ojousima/poppimASiina/hardware/LTSpice/differential2single.asc

C2: cap; 470µ
C3: cap; 470µ
C5: cap; 47p
C6: cap; 47p
C8: cap; 150µ
C9: cap; 150µ
R1: res; 10k
R2: res; 10k
R3: res; 10k
R4: res; 10k
R5: res; 16
R8: res; 10k
R9: res; 10k
R10: res; 10k
R11: res; 10k
R12: res; 16
R19: res; 16
R20: res; 16
U2: LT6221
U4: LT6221
U5: LTC660
V1: voltage; 4.2
V2: voltage; SINE(0 0.25 1k 0 0 0 1k); AC 0.5
V3: voltage; SINE(0 0.25 1k 0 0 0 1k); AC 0.5
V4: voltage; 1.5
V5: voltage; SINE(0 0.25 1k 0 0 0 1k); AC 0.5
V6: voltage; SINE(0 0.25 1k 0 0 0 1k); AC 0.5
V7: voltage; 1.5
V8: voltage; 1.5
V9: voltage; 1.5
Named nets: 0, VAA, LEFT_OUT, LEFT_IN-, LEFT_IN+, VCOM, RIGHT_OUT, RIGHT_IN-, RIGHT_IN+, RIGHT_SE, LEFT_SE, VEE
.OPTIONS plotwinsize=0
.OPTIONS numdgt=7
.tran 0 150m 100m 1u startup
;ac oct 1k 1m 100meg
.FOUR 1k 10 V(RIGHT_OUT)
