ojousima/poppimASiina/hardware/LTSpice/analog.asc

C1: cap; 2µ2
C2: cap; 470µ
C3: cap; 470µ
C4: cap; 470µ
C5: cap; 47p
C6: cap; 47p
C7: cap; 47p
R1: res; 10k
R2: res; 10k
R3: res; 10k
R4: res; 10k
R5: res; 5k
R6: res; 1meg
R7: res; 1meg
R8: res; 10k
R9: res; 10k
R10: res; 10k
R11: res; 10k
R12: res; 5k
R13: res; 10k
R14: res; 10k
R15: res; 10k
R16: res; 10k
R17: res; 5k
R18: res; 5k
R19: res; 5k
R20: res; 5k
U1: LTC6255
U2: LTC6255
U3: LTC6255
U4: LTC6255
V1: voltage; 4.2
V2: voltage; wavefile=leftch_in.wav
V3: voltage; wavefile=leftch_in.wav
V4: voltage; 1.5
V5: voltage; wavefile=rightch_in.wav
V6: voltage; wavefile=rightch_in.wav
V7: voltage; 1.5
V8: voltage; 1.5
V9: voltage; 1.5
Named nets: 0, VAA, LEFT_OUT, LEFT_IN-, LEFT_IN+, VCOM, RIGHT_OUT, RIGHT_IN-, RIGHT_IN+, MONO_OUT, LEFT_SE, RIGHT_SE
.OPTIONS plotwinsize=0
.OPTIONS numdgt=7
.tran 0 35 0 1u startup
.wave "rightch_out.wav"  16 44k1 V(RIGHT_OUT)
.wave "leftch_out.wav"  16 44k1 V(MONO_OUT)
.wave "mono_out.wav" 16 44k1 V(MONO_OUT)
.wave "left_monitor.wav" 16 44k1 V(LEFT_IN+)
.wave "right_monitor.wav" 16 44k1 V(RIGHT_IN+)
