ojousima/poppimASiina/hardware/musamasiina.kicad_pcb

## KiCad design hardware/musamasiina.kicad_pcb (2016-06-10)

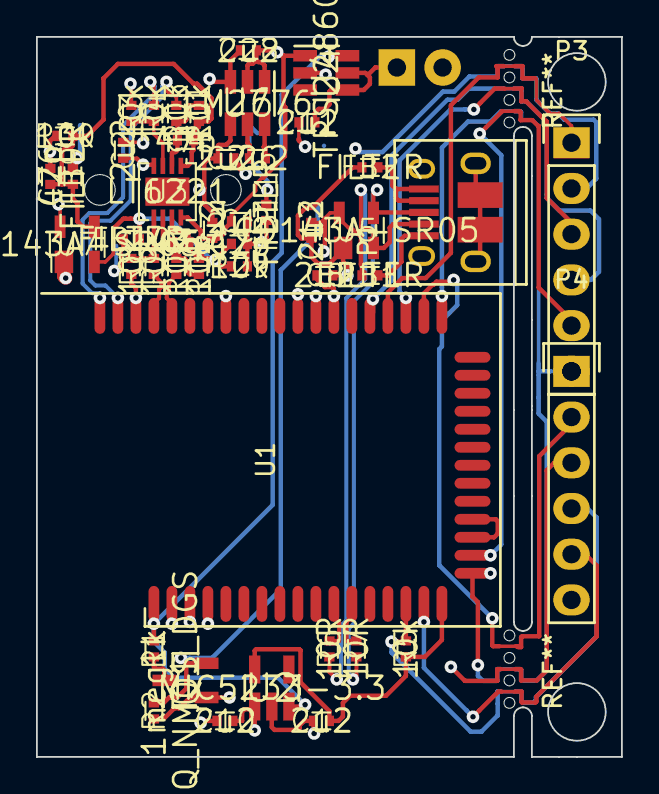
[picture p1: board musamasiina.kicad_pcb from above]

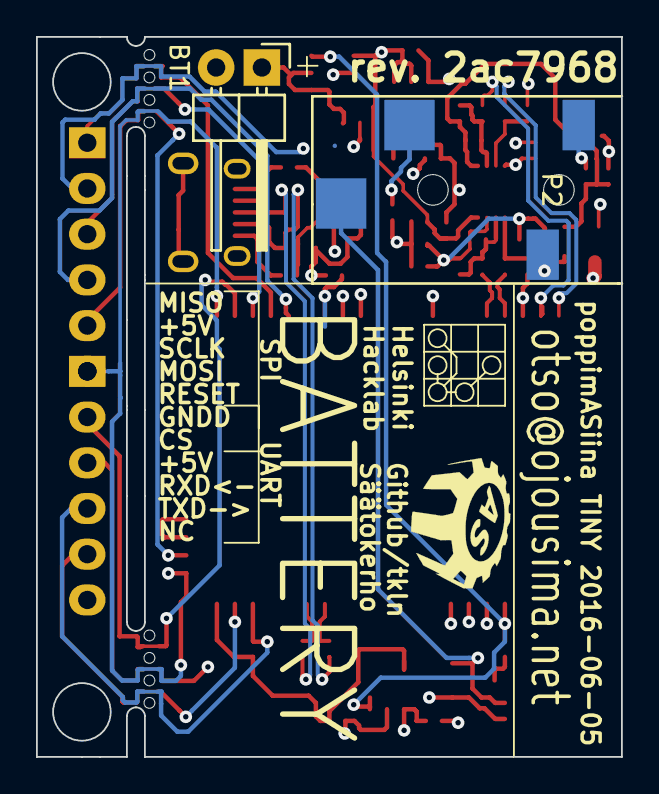
[picture p2: board musamasiina.kicad_pcb from below]

Board: 4 copper layers, 32.5 x 40.0 mm, 48 parts (2 on the bottom side), 39 nets.

Parts:
BT1: Battery; Pin_Header_Angled_1x02
C1, C2, C3, C6, C7, C8, C10, C11, C12, C13, C28: 2u2; SMD0402-CAP-N
C4, C5, C26, C27: 47p; SMD0402-CAP-N
FB1, FB2, FB9, FB10, FB11: FILTER; SMD0402-FERRITE-N
P1: USB_OTG; USB_Micro-B_10103594-0001LF
P2: CONN_01X04; SMD_3-5mm_jack_CUI-SJ-352X-SMT
P3: CONN_02X03; Pin_Header_Straight_1x06
P4: CONN_01X06; Pin_Header_Straight_1x06
Q1: Q_NMOS_DGS; SOT23-M
R1: 1k; SMD0402-RES-N
R2: 1meg; SMD0402-RES-N
R3, R4, R5, R8, R9, R10, R11, R12, R13, R29, R30: 10k; SMD0402-RES-N
R6, R7: 10R; SMD0402-RES-N
U1: WT32
U2: MIC5233-3.3; SOT23-5-M
U3: LT6221; DFN-8-EP-0_5mm_3x3mm-N
U4: TPS22860; SOT23-6-M
U5, U7: CD143A-SR05; SOT143-N
U6: LM2776; SOT23-6-M

Connections:
+5V: C13.1, FB1.2, P3.2, P4.3, U1.38, U5.4
+BATT: BT1.1, C8.1, C10.1, C11.1, Q1.1, R2.1, U1.37, U2.1, U4.4, U4.5
/AUDIO_SWITCH: P2.4, Q1.2, R2.2
/CD+: R7.1, U1.12
/CD-: R6.1, U1.11
/CS: P4.2, U1.32
/LO_N: R13.2, U1.49
/LO_P: R4.2, U1.50
/MISO: P3.1, U1.34
/MOSI: P3.4, U1.35
/Power Supply/ENABLE: R1.1, U1.1, U2.3, U4.6
/Power Supply/GNDBUS: FB2.1, P1.4, P1.5
/Power Supply/VBUS: FB1.1, P1.1
/RESET: P3.5, U1.19
/RO_N: R10.2, U1.46
/RO_P: R9.2, U1.47
/RXD: P4.4, R5.1, U1.15
/SCLK: P3.3, U1.33
/Stereo out/GROUND_CABLE: FB11.2, P2.2
/Stereo out/LEFT_CABLE: FB9.2, P2.1
/Stereo out/LEFT_DEVICE: C4.1, C26.1, FB9.1, R11.1, R30.1, U3.1, U7.3
/Stereo out/RIGHT_CABLE: FB10.2, P2.3
/Stereo out/RIGHT_DEVICE: C5.1, C27.1, FB10.1, R12.1, R29.1, U3.7, U7.2
/TXD: P4.5, U1.16
/USB_D+: P1.3, R7.2, U5.3
/USB_D-: P1.2, R6.2, U5.2
GNDA: C1.2, C2.2, C7.2, C26.2, C27.2, C28.2, FB11.1, R3.2, R8.2, R29.2, R30.2, U1.39, U1.43, U1.48, U4.2, U6.3
GNDD: BT1.2, C8.2, C10.2, C11.2, C12.2, C13.2, FB2.2, P3.6, P4.1, U1.2, U1.3, U1.4, U1.18, U1.31, U2.2, U5.1
unnamed: C4.2, R11.2, R13.1, U3.2
unnamed: C5.2, R10.1, R12.2, U3.6
unnamed: C6.1, U6.5
unnamed: C6.2, U6.6
unnamed: Q1.3, R1.2
unnamed: R3.1, R4.1, U3.3
unnamed: R8.1, R9.1, U3.5
unnamed: U1.20, U1.21
VAA: C1.1, C3.1, C28.1, U3.8, U4.1, U6.1, U6.2, U7.4
VDD: C12.1, R5.2, U1.17, U2.5
VEE: C2.1, C3.2, C7.1, U3.4, U6.4, U7.1
