ojousima/poppimASiina/hardware/printout/simulation/differential2single-bode.png

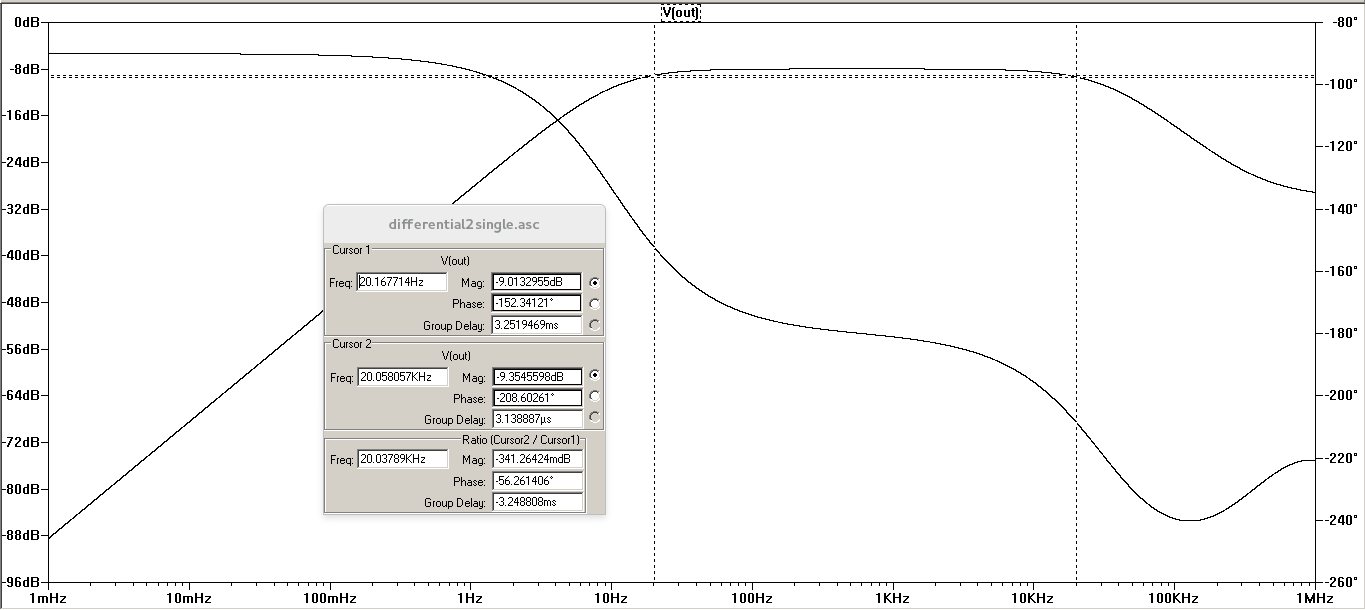
hardware/printout/simulation/differential2single-bode.png
