ojousima/poppimASiina/hardware/printout/simulation/differential2single-DC-32load-2v7supply.png

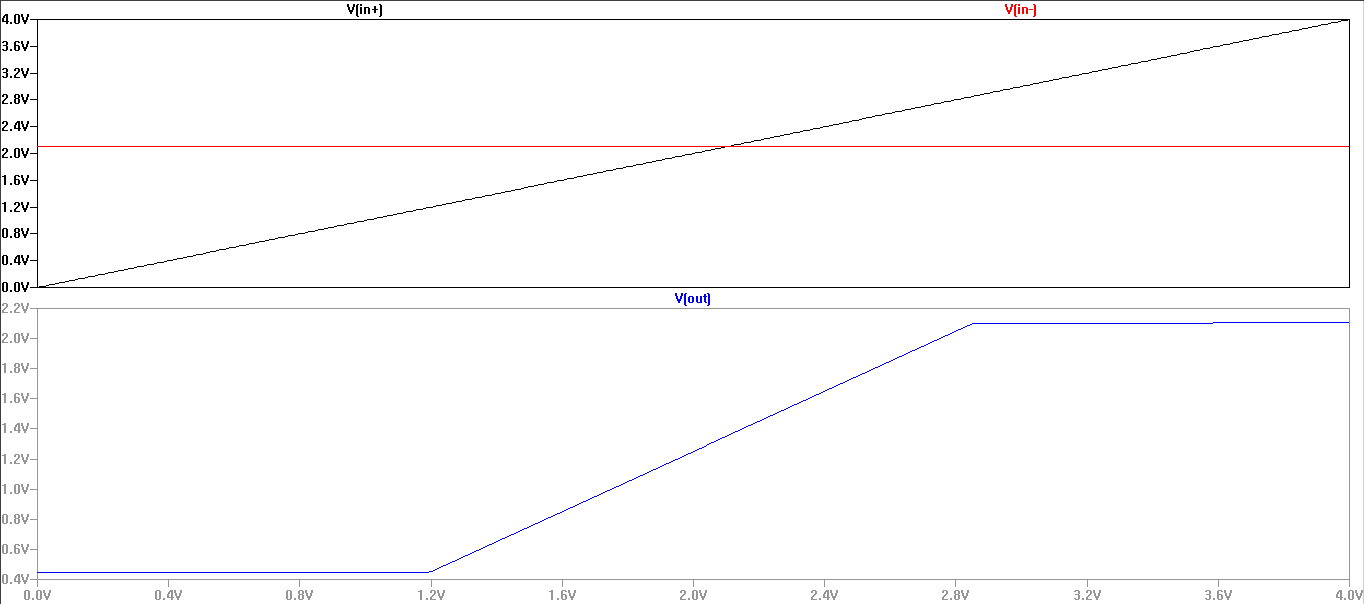
hardware/printout/simulation/differential2single-DC-32load-2v7supply.png
