ojousima/poppimASiina/hardware/printout/simulation/differential2single-DC-32load-4v2supply.png

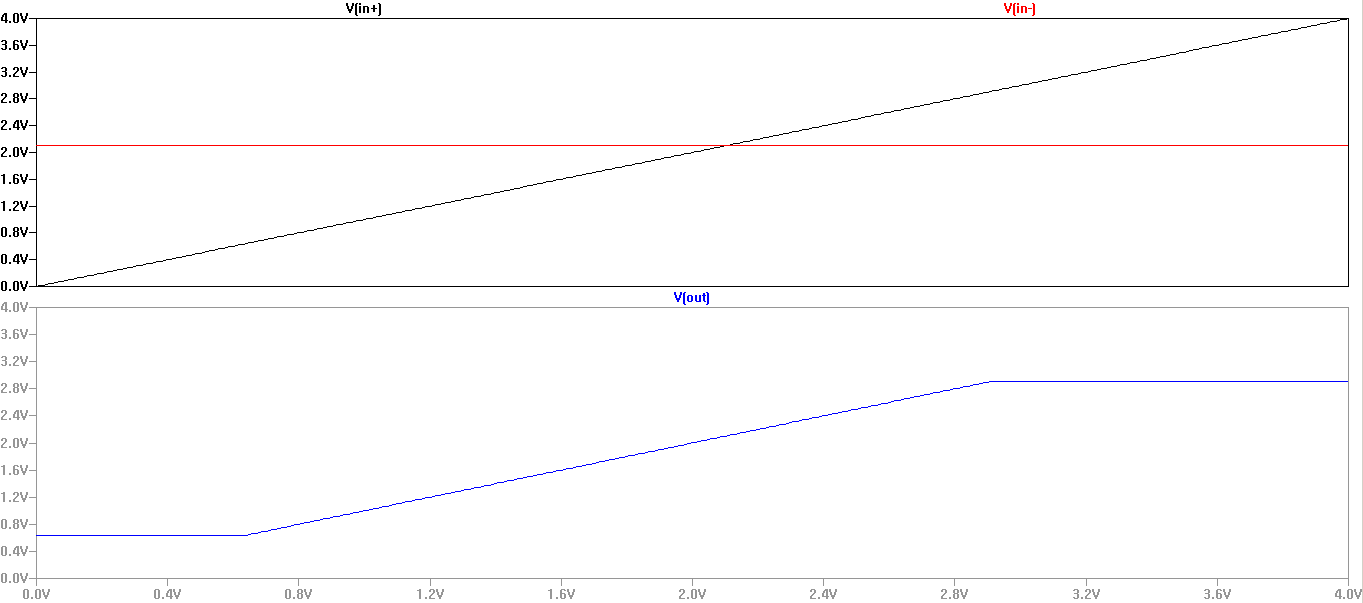
hardware/printout/simulation/differential2single-DC-32load-4v2supply.png
