ojousima/poppimASiina/hardware/printout/simulation/differential2single-FFT.png

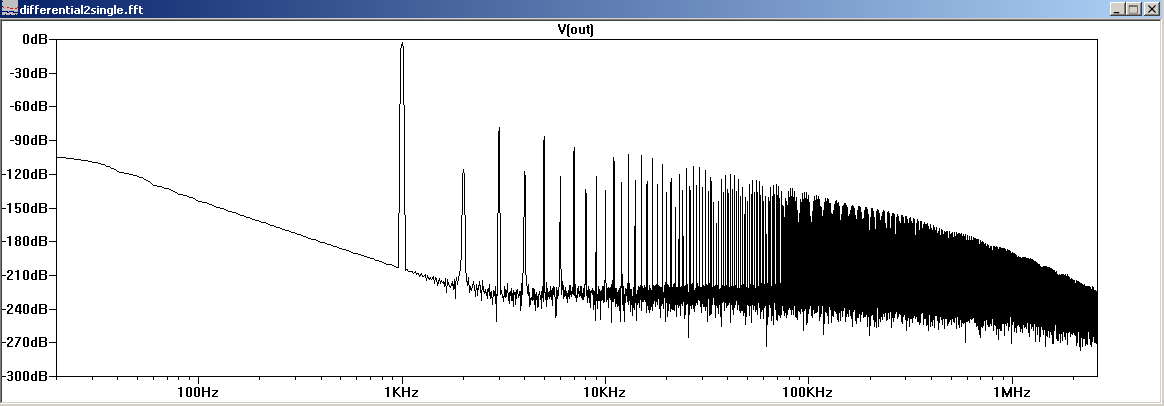
hardware/printout/simulation/differential2single-FFT.png
