ojousima/poppimASiina/hardware/printout/simulation/differential2single-noise.png

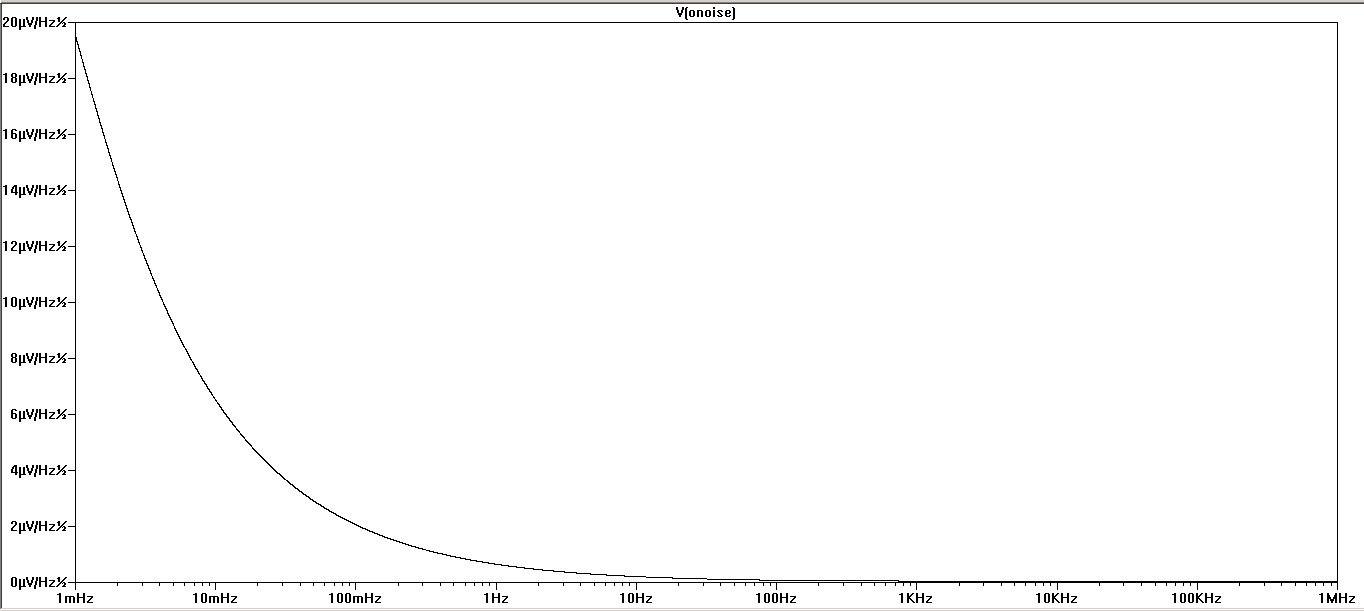
hardware/printout/simulation/differential2single-noise.png
