ojousima/poppimASiina/hardware/printout/simulation/differential2single.png

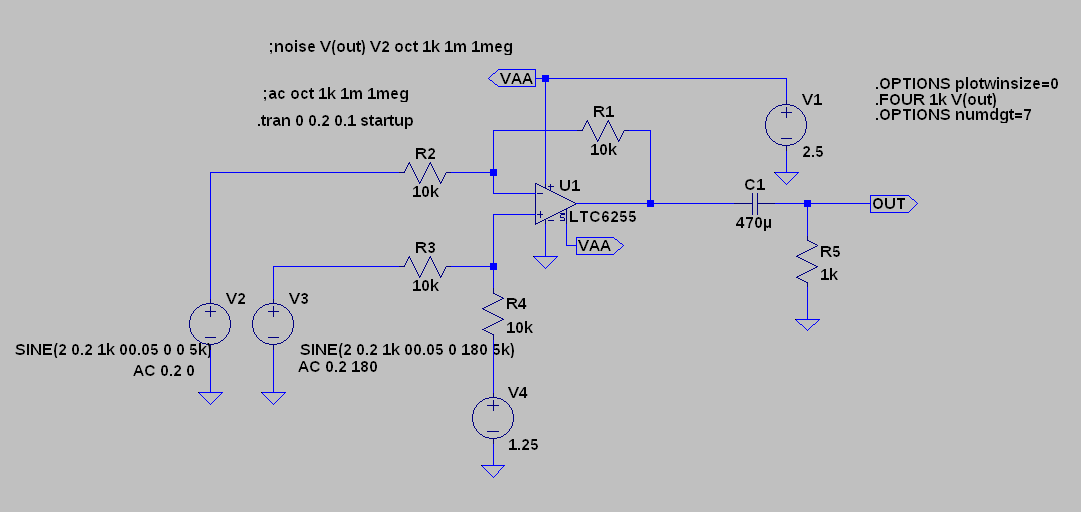
hardware/printout/simulation/differential2single.png
