ojousima/poppimASiina/hardware/printout/simulation/differential2single_TD.png

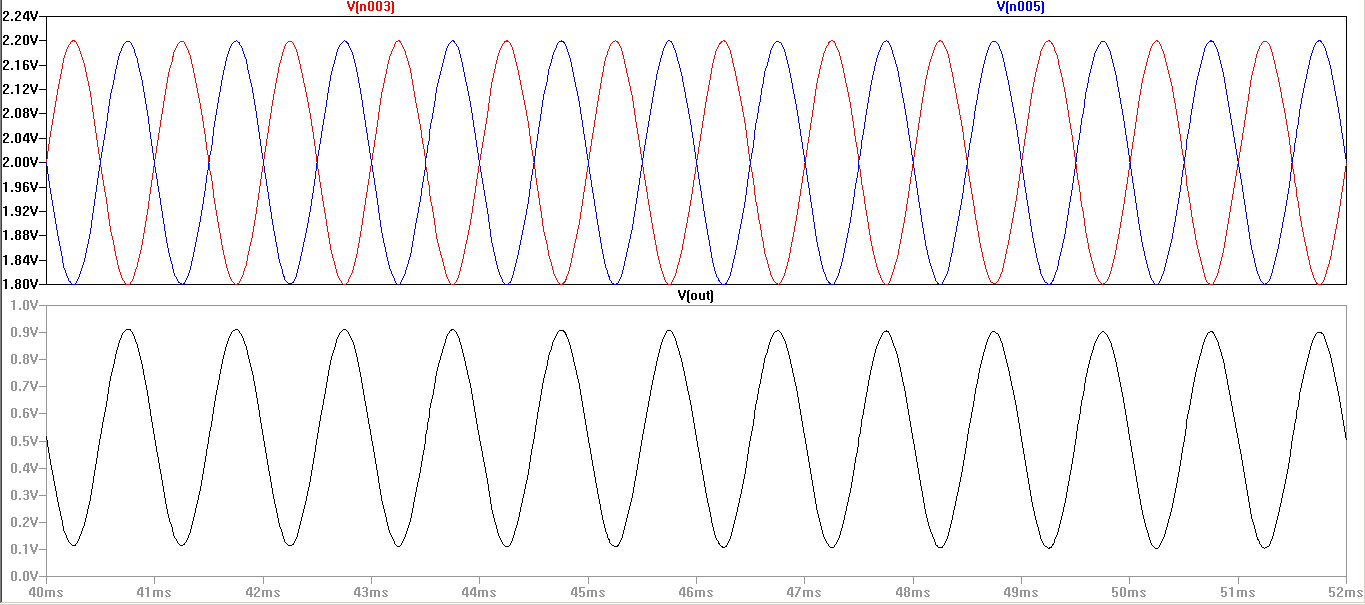
hardware/printout/simulation/differential2single_TD.png
