ojousima/poppimASiina/(threads)

Thread 1 (2016-05-19):

ID pin connection?

ojousima, 2016-05-19:
ID pin on USB connector should be connected to a defined level. A quick search on internet suggests ground ID pin would signal OTG devices to act as a master, so maybe ID pin should be grounded?

Thread 3 (2016-05-19):

TPS22860 grounding?

ojousima, 2016-05-19:
The load switch TPS22860 has only one ground pin. Should it be connected on load side GNDA or source side GNDD?

ojousima, 2016-05-20:
Datasheet has ground (and bypass cap) next to VOUT, so maybe GNDA?

Thread 5 (2016-05-19):

UART pins are not brought out

ojousima, 2016-05-19:
FTDI-cable compatible programming header would be nice.

ojousima, 2016-05-21:
Fixed in 85a3737

Closed 2016-05-21.

Thread 7 (2016-05-21):

PCB footprints

ojousima, 2016-05-21:
SOT23-5 and SOT23-6 should have their 3D axis rotated around Z-axis by 270 deg.
SOT23-6 needs pin 1 indicator.
SOT23-3 has misplaced pads.

Thread 10 (2016-05-28):

DC-level setting resistors after DC-decoupling of audio IO

ojousima, 2016-05-28:
As there is no resistive path to ground after DC-decoupling of audio stages, there is going to be click & pop when cable is connected. This could be reduced by adding a high value resistor on the signal lines, maybe 1 meg or so.

Closed 2016-05-31.

Thread 12 (2016-05-31):

USB footprint

ojousima, 2016-05-31:
A completely SMD-version of USB connector would allow a button on the other side of the board. On the other hand, full SMD-footprint might be less robust. Should it be changed?

Thread 13 (2016-05-31):

Battery reverse protection, connector.

ojousima, 2016-05-31:
Add reverse protection (NMOS on ground?) and decide on battery connector footprint.

Thread 14 (2016-05-31):

On/Off button selection

ojousima, 2016-05-31:
Panel mount buttons tend to be large (adds to height of device), suitable SMD buttons are expensive (4-5 USD) or would need additional mechanics.

A button type needs to be selected.
