ojousima/poppimASiina/(commit log)

2016-05-15 Ignore kicad backup, autogenerated files
2016-05-15 Add header, printout
    [musamasiina.sch]
2016-05-15 Add printouts of simulation results
2016-05-15 Add analog sections to schematic
    [musamasiina.sch]
2016-05-15 Update schematic printout
2016-05-15 Fix ESD-protection diodes
    [musamasiina.sch]
2016-05-15 Update printouts
    [musamasiina.sch]
2016-05-15 Start vorking on PSU
    [musamasiina.sch]
2016-05-15 Update printout
2016-05-19 Schematic ready for review
    [musamasiina.sch]
2016-05-19 Update header, printout
    [musamasiina.sch]
2016-05-20 Fix #2
    Corrected BAT54S pin order, updated schematic
    [musamasiina.sch]
2016-05-20 Add AC-coupling caps to mic input. Fixes #4
    [musamasiina.sch]
2016-05-21 divide schematic into subscheets
    [analog.sch, musamasiina.sch, psu.sch]
2016-05-21 Add user IO, programming headers
    [analog.sch, audioio.sch, musamasiina.sch, psu.sch]
2016-05-21 update schematic headers, printouts
    [analog.sch, audioio.sch, musamasiina.sch, psu.sch]
2016-05-21 Add standard footprints
2016-05-31 Fix annotation of VESD resistors
    Fix annotation of VESD resistors
    [analog.sch, audioio.sch, musamasiina.sch, psu.sch]
2016-05-31 draft PCB outline, import standard components
    [musamasiina.kicad_pcb]
2016-05-31 Start placement of parts
    [analog.sch, audioio.sch, musamasiina.kicad_pcb, musamasiina.sch, psu.sch]
2016-05-31 Update footprints
2016-05-31 Continue placing parts
    [musamasiina.kicad_pcb]
2016-05-31 Add resistors from audio IO to gnd, fixes #10
    [audioio.sch]
2016-05-31 Fix #9
    [analog.sch]
2016-05-31 Fix #8
    [analog.sch, audioio.sch, musamasiina.sch, psu.sch]
2016-05-31 Adjust layout
    [analog.sch, audioio.sch, musamasiina.kicad_pcb, musamasiina.sch, psu.sch]
2016-05-31 Add KiCAD footprints to project folder
    [musamasiina.kicad_pcb]
2016-05-31 Update schematics
    [analog.sch, audioio.sch, musamasiina.sch, psu.sch]
2016-05-31 Update layout
    [musamasiina.kicad_pcb]
2016-05-31 Add music sample to simulation
2016-06-04 Make minimal circuitry
    [analog.sch, audioio.sch, musamasiina.sch, psu.sch]
2016-06-04 Layout board
    [musamasiina.kicad_pcb]
2016-06-04 Add production files, printouts
    [audioio.sch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]
2016-06-10 Finalize design
    [audioio.sch, musamasiina.kicad_pcb, musamasiina.sch, psu.sch]
